jankae/BLDCDriver/Hardware/Driver.pdf

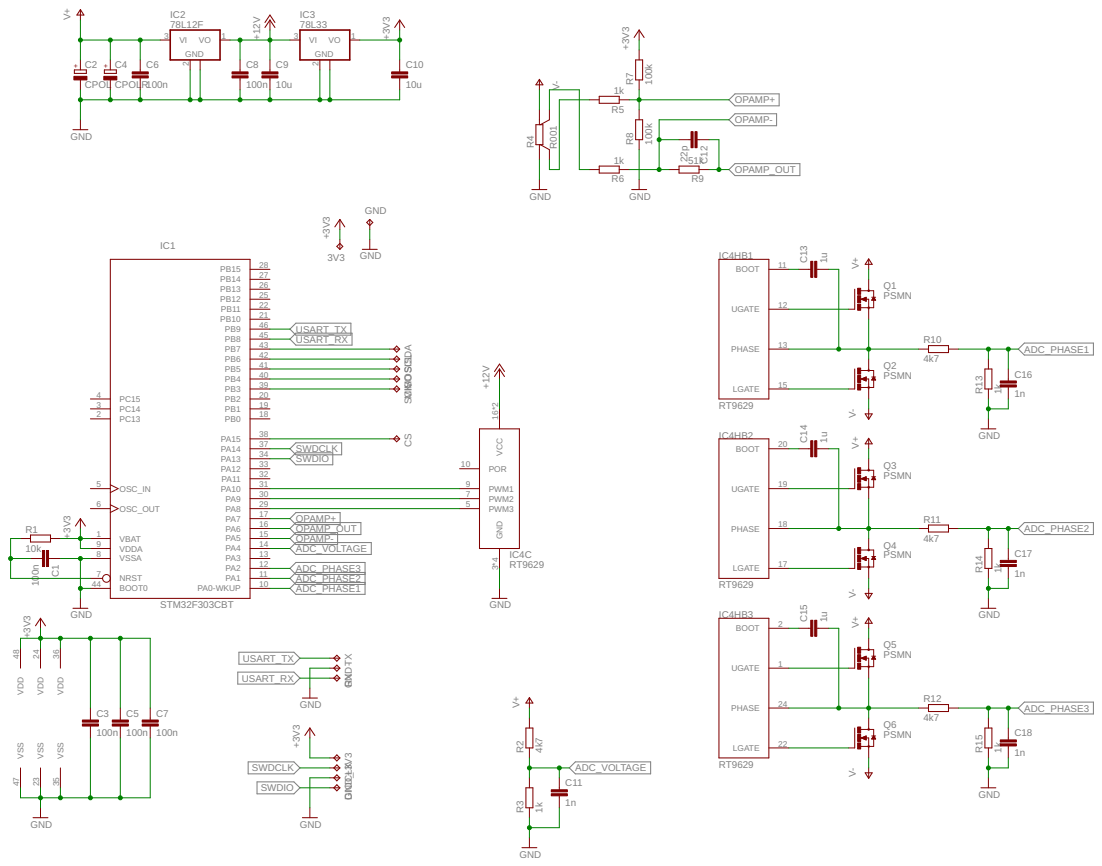
[picture p1: page 1]
