jankae/BLDCDriver/Hardware/Driver.brd

## EAGLE design Hardware/Driver.brd (2018-08-25)

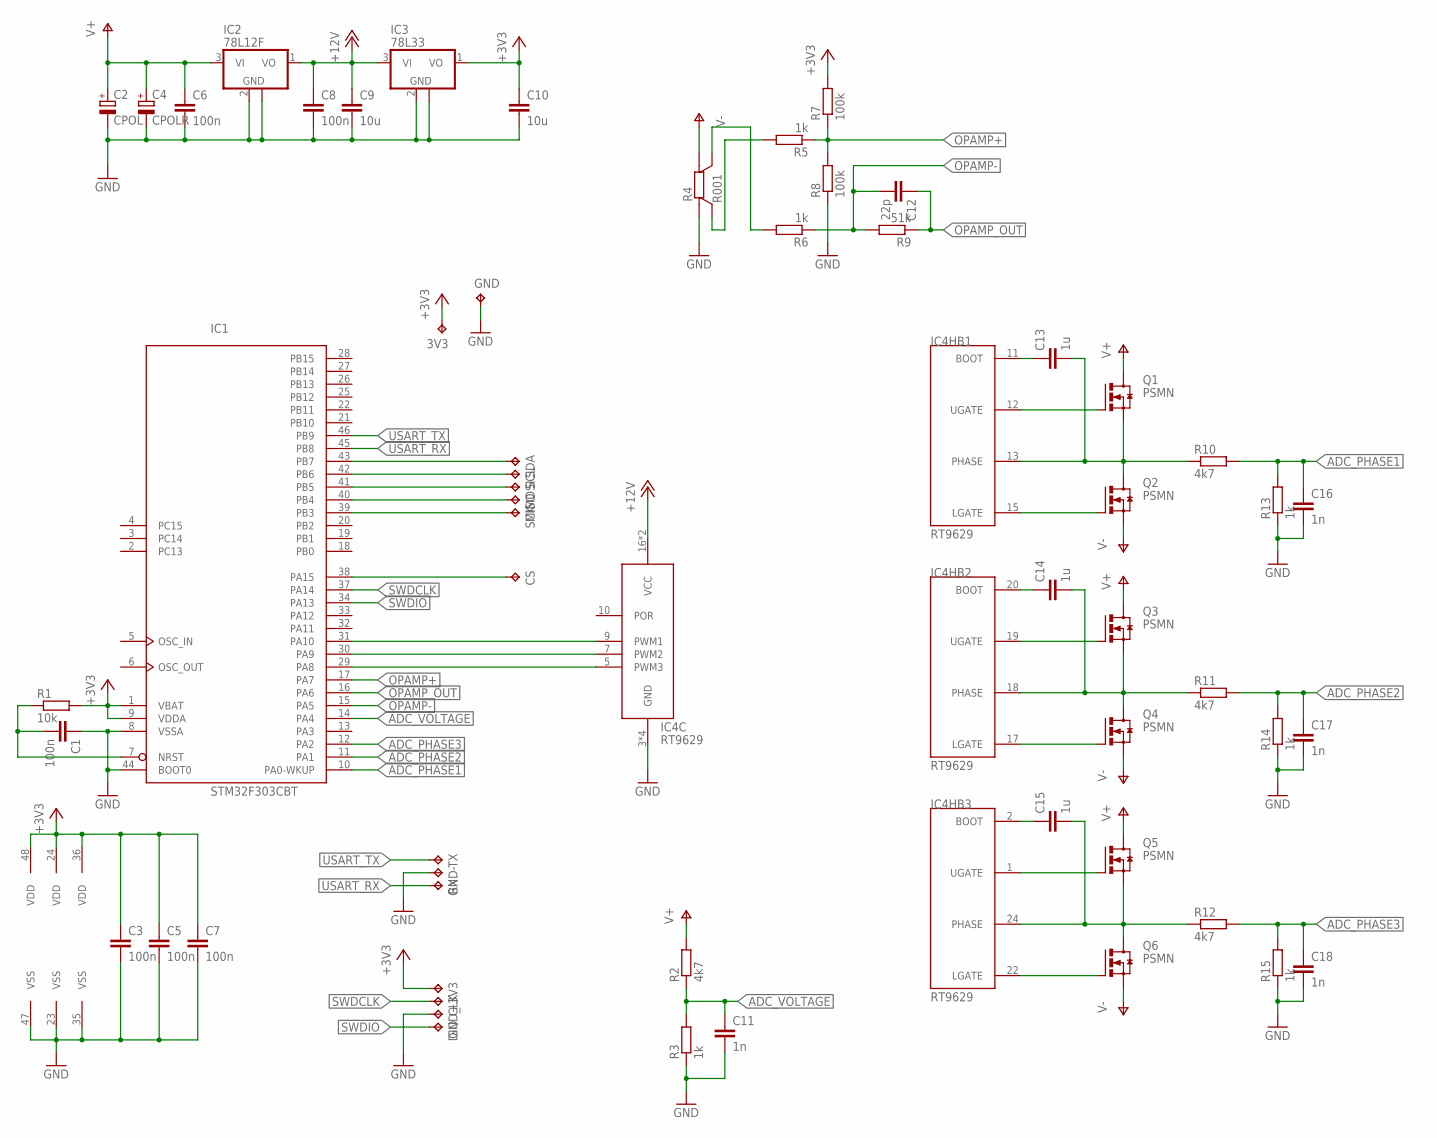
[picture p2: schematic Driver.sch]

Parts:
3V3: TPTP10SQ; TP10SQ
+3V3: TPTP15R; TP15R
C1, C3, C5, C6, C7, C8: 100n; C0603K
C2: CPOL; SIDEWAYS-5.08
C4: CPOLR; SIDEWAYS-5.08R
C9, C10: 10u; C1206K
C11, C16, C17, C18: 1n; C0603K
C12: 22p; C0603K
C13, C14, C15: 1u; C0603K
CLK: TPTP15R; TP15R
CS: TPTP10SQ; TP10SQ
DIO: TPTP15R; TP15R
GND: TPTP10SQ; TP10SQ
GND-: TPTP15SQ; TP15SQ
GND_: TPTP15SQ; TP15SQ
IC1: STM32F303CBT; LQFP48
IC2: 78L12F; SOT89
IC3: 78L33; SOT89
IC4: RT9629; WQFN24
MISO: TPTP10SQ; TP10SQ
MOSI: TPTP10SQ; TP10SQ
Q1, Q2, Q3, Q4, Q5, Q6: PSMN; SOT669
R1: 10k; R0603
R2, R10, R11, R12: 4k7; R0603
R3, R5, R6, R13, R14, R15: 1k; R0603
R4: R001; WSK1216
R7, R8: 100k; R0603
R9: 51k; R0603
RX: TPTP15R; TP15R
SCK: TPTP10SQ; TP10SQ
SCL: TPTP10SQ; TP10SQ
SDA: TPTP10SQ; TP10SQ
TX: TPTP15R; TP15R

Connections:
+3V3: 3V3.TP, +3V3.TP, C3.1, C5.1, C7.1, C10.1, IC1.1 (VBAT), IC1.9 (VDDA), IC1.24 (VDD), IC1.36 (VDD), IC1.48 (VDD), IC3.1 (VO), R1.2, R7.2
+12V: C8.1, C9.1, IC2.1 (VO), IC3.3 (VI), IC4.16 (VCC), IC4.21 (VCC)
ADC_PHASE1: C16.1, IC1.10 (PA0-WKUP), R10.2, R13.2
ADC_PHASE2: C17.1, IC1.11 (PA1), R11.2, R14.2
ADC_PHASE3: C18.1, IC1.12 (PA2), R12.2, R15.2
ADC_VOLTAGE: C11.1, IC1.14 (PA4), R2.1, R3.2
GND: C1.1, C2.-, C3.2, C4.-, C5.2, C6.2, C7.2, C8.2, C9.2, C10.2, C11.2, C16.2, C17.2, C18.2, GND.TP, GND-.TP, GND_.TP, IC1.8 (VSSA), IC1.23 (VSS), IC1.35 (VSS), IC1.44 (BOOT0), IC1.47 (VSS), IC2.2 (GND), IC2.2@1 (GND), IC3.2 (GND), IC3.2@1 (GND), IC4.3 (GND), IC4.14 (GND), IC4.23 (GND), IC4.E (GND), R3.1, R4.B, R8.1, R13.1, R14.1, R15.1
I2C_SCL: IC1.42 (PB6), SCL.TP
I2C_SDA: IC1.43 (PB7), SDA.TP
unnamed: IC4.12 (UGATE), Q1.4 (G)
unnamed: IC4.15 (LGATE), Q2.4 (G)
unnamed: C13.1, IC4.11 (BOOT)
unnamed: C14.1, IC4.20 (BOOT)
unnamed: IC4.19 (UGATE), Q3.4 (G)
unnamed: IC4.17 (LGATE), Q4.4 (G)
unnamed: C15.1, IC4.2 (BOOT)
unnamed: IC4.1 (UGATE), Q5.4 (G)
unnamed: IC4.22 (LGATE), Q6.4 (G)
unnamed: C1.2, IC1.7 (NRST), R1.1
unnamed: R4.SA, R6.2
unnamed: R4.SB, R5.2
OPAMP+: IC1.17 (PA7), R5.1, R7.1, R8.2
OPAMP-: C12.2, IC1.15 (PA5), R6.1, R9.2
OPAMP_OUT: C12.1, IC1.16 (PA6), R9.1
PHASE1: C13.2, IC4.13 (PHASE), Q1.1 (S), Q1.2 (S), Q1.3 (S), Q2.MB (D), R10.1
PHASE2: C14.2, IC4.18 (PHASE), Q3.1 (S), Q3.2 (S), Q3.3 (S), Q4.MB (D), R11.1
PHASE3: C15.2, IC4.24 (PHASE), Q5.1 (S), Q5.2 (S), Q5.3 (S), Q6.MB (D), R12.1
PWM1: IC1.31 (PA10), IC4.9 (PWM1)
PWM2: IC1.30 (PA9), IC4.7 (PWM2)
PWM3: IC1.29 (PA8), IC4.5 (PWM3)
SPI_MISO: IC1.40 (PB4), MISO.TP
SPI_MOSI: IC1.41 (PB5), MOSI.TP
SPI_NSS: CS.TP, IC1.38 (PA15)
SPI_SCK: IC1.39 (PB3), SCK.TP
SWDCLK: CLK.TP, IC1.37 (PA14)
SWDIO: DIO.TP, IC1.34 (PA13)
USART_RX: IC1.45 (PB8), RX.TP
USART_TX: IC1.46 (PB9), TX.TP
V+: C2.+, C4.+, C6.1, IC2.3 (VI), Q1.MB (D), Q3.MB (D), Q5.MB (D), R2.2
V-: Q2.1 (S), Q2.2 (S), Q2.3 (S), Q4.1 (S), Q4.2 (S), Q4.3 (S), Q6.1 (S), Q6.2 (S), Q6.3 (S), R4.A

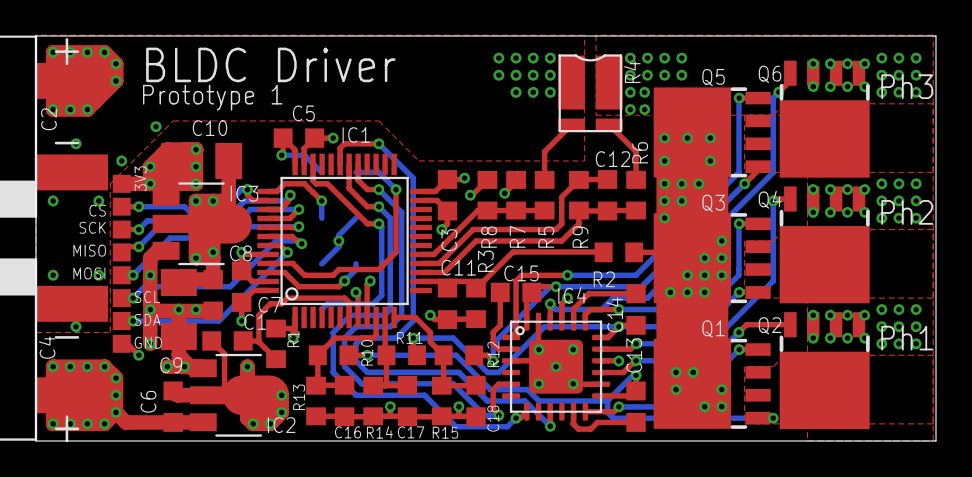
[picture p3: board Driver.brd from above]

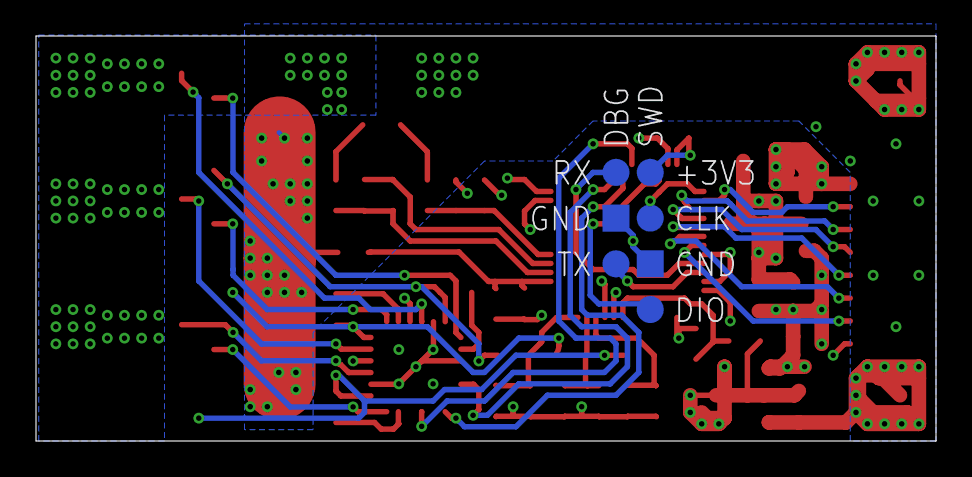
[picture p4: board Driver.brd from below]

Board: 4 copper layers, 50.0 x 22.5 mm, 58 parts (7 on the bottom side), 40 nets.
