jankae/BLDCDriver/Software/BLDC/BLDC.ioc

Mcu.UserName=STM32F303C8Tx
PA0.Signal=ADC1_IN1
PA1.Signal=ADC1_IN2
PA10.GPIO_Label=PHASE_A
PA10.Signal=S_TIM1_CH3
PA13.Signal=SYS_JTMS-SWDIO
PA14.Signal=SYS_JTCK-SWCLK
PA15.Signal=SPI1_NSS
PA2.Signal=ADC1_IN3
PA4.Signal=ADC2_IN1
PA5.Signal=OPAMP2_VINM
PA6.Signal=OPAMP2_VOUT
PA7.Signal=OPAMP2_VINP
PA8.GPIO_Label=PHASE_C
PA8.Signal=S_TIM1_CH1
PA9.GPIO_Label=PHASE_B
PA9.Signal=S_TIM1_CH2
PB11.Signal=USART3_RX
PB3.Signal=SPI1_SCK
PB4.Signal=SPI1_MISO
PB5.Signal=SPI1_MOSI
PB6.Signal=I2C1_SCL
PB7.Signal=I2C1_SDA
PB8.GPIO_Label=TRIGGER
PB8.Signal=GPIO_Output
PB9.Signal=USART3_TX
