jankae/BLDCDriver/Software/BLDC/Inc/main.h

#define PHASE_C_Pin GPIO_PIN_8
#define PHASE_C_GPIO_Port GPIOA
#define PHASE_B_Pin GPIO_PIN_9
#define PHASE_B_GPIO_Port GPIOA
#define PHASE_A_Pin GPIO_PIN_10
#define PHASE_A_GPIO_Port GPIOA
#define TRIGGER_Pin GPIO_PIN_8
#define TRIGGER_GPIO_Port GPIOB
