jankae/BLDCDriver/Software/BLDC/Core/Sysinfo.hpp

#pragma once

#include "BLDCHAL.hpp"

//namespace HAL {
//namespace BLDC {
//class HALDriver;
//}
//}

namespace Core {
// Forward declare used classes
class Communication;
class Propeller;

using Sysinfo = struct sysinfo {
	Propeller *prop;
	Communication *communication;
	HAL::BLDC::HALDriver *driver;
};

}
