jankae/BLDCDriver/Software/BLDC/HAL/PowerADC.hpp

#pragma once

#include <cstdint>

namespace HAL {
namespace BLDC {
namespace PowerADC {

using Measurement = struct meas {
	uint32_t voltage; // in mV
	int32_t current; // in mA
	uint32_t energy; // in uJ
};

void Init();
void Pause();
void Resume();

void SetMaximumVoltageThreshold(uint16_t mV);
bool VoltageWithinLimits();

void DMAComplete();
void DMAHalfComplete();

void PrintBuffer();

int32_t CurrentFromRaw(uint16_t adc);
uint32_t VoltageFromRaw(uint16_t adc);

Measurement GetSmoothed();
Measurement GetInstant();


}
}
}
