jankae/BLDCDriver/Software/BLDC/Src/Operators.cpp

#include "FreeRTOS.h"
#include <cstdio>

void * operator new(size_t size)
{
	return pvPortMalloc(size);
}

void * operator new[](size_t size)
{
	return pvPortMalloc(size);
}

void operator delete(void* ptr)
{
    vPortFree(ptr);
}

void operator delete(void* ptr, unsigned int size)
{
    vPortFree(ptr);
}

void operator delete[](void* ptr)
{
    vPortFree(ptr);
}

void operator delete[](void* ptr, unsigned int size)
{
    vPortFree(ptr);
}
