jankae/BLDCDriver/Software/BLDC/HAL/Tests.cpp

#include "Tests.hpp"

#include "FreeRTOS.h"
#include "task.h"
#include "stm32f3xx_hal.h"
#include "lowlevel.hpp"
#include "Logging.hpp"
#include "Driver.hpp"
#include "InductanceSensing.hpp"
#include "PowerADC.hpp"
#include "Persistance.hpp"
#include "Sysinfo.hpp"
#include "Propeller.hpp"

extern Core::Sysinfo sys;
extern HAL::BLDC::Driver *d;

using namespace HAL::BLDC;

void Test::DifferentPWMs(void) {
	Log::Uart(Log::Lvl::Inf, "Test, setting different PWMs");
	LowLevel::SetPWM(100);
	LowLevel::SetPhase(LowLevel::Phase::A, LowLevel::State::High);
	LowLevel::SetPhase(LowLevel::Phase::B, LowLevel::State::Low);
	LowLevel::SetPhase(LowLevel::Phase::C, LowLevel::State::Idle);
}

void Test::MotorFunctions(void) {
	while (1) {
		sys.driver->InitiateStart();
		vTaskDelay(3000);
		constexpr uint16_t maxPWM = 200;
		for (uint16_t pwm = 100; pwm <= maxPWM; pwm++) {
			sys.driver->SetPWM(pwm);
			vTaskDelay(10);
		}
		for (uint16_t pwm = maxPWM; pwm > 100; pwm--) {
			sys.driver->SetPWM(pwm);
			vTaskDelay(10);
		}
		sys.driver->Stop();
		vTaskDelay(2000);
	}
}

static void SetStep(uint8_t step) {
	switch (step) {
	case 0:
		LowLevel::SetPhase(LowLevel::Phase::A, LowLevel::State::High);
		LowLevel::SetPhase(LowLevel::Phase::B, LowLevel::State::Idle);
		LowLevel::SetPhase(LowLevel::Phase::C, LowLevel::State::Low);
		break;
	case 1:
		LowLevel::SetPhase(LowLevel::Phase::A, LowLevel::State::High);
		LowLevel::SetPhase(LowLevel::Phase::B, LowLevel::State::Low);
		LowLevel::SetPhase(LowLevel::Phase::C, LowLevel::State::Idle);
		break;
	case 2:
		LowLevel::SetPhase(LowLevel::Phase::A, LowLevel::State::Idle);
		LowLevel::SetPhase(LowLevel::Phase::B, LowLevel::State::Low);
		LowLevel::SetPhase(LowLevel::Phase::C, LowLevel::State::High);
		break;
	case 3:
		LowLevel::SetPhase(LowLevel::Phase::A, LowLevel::State::Low);
		LowLevel::SetPhase(LowLevel::Phase::B, LowLevel::State::Idle);
		LowLevel::SetPhase(LowLevel::Phase::C, LowLevel::State::High);
		break;
	case 4:
		LowLevel::SetPhase(LowLevel::Phase::A, LowLevel::State::Low);
		LowLevel::SetPhase(LowLevel::Phase::B, LowLevel::State::High);
		LowLevel::SetPhase(LowLevel::Phase::C, LowLevel::State::Idle);
		break;
	case 5:
		LowLevel::SetPhase(LowLevel::Phase::A, LowLevel::State::Idle);
		LowLevel::SetPhase(LowLevel::Phase::B, LowLevel::State::High);
		LowLevel::SetPhase(LowLevel::Phase::C, LowLevel::State::Low);
		break;
	}
}

void Test::InductanceSense() {
	delete sys.driver;
	while (1) {
		int8_t pos = InductanceSensing::RotorPosition();
		Log::Uart(Log::Lvl::Inf, "Pos: %d", pos);
		pos = (pos + 1) % 6;
		LowLevel::SetPWM(100);
		SetStep(pos);
		vTaskDelay(1000);
		LowLevel::SetPWM(0);
		LowLevel::SetPhase(LowLevel::Phase::A, LowLevel::State::Idle);
		LowLevel::SetPhase(LowLevel::Phase::B, LowLevel::State::Idle);
		LowLevel::SetPhase(LowLevel::Phase::C, LowLevel::State::Idle);
		vTaskDelay(1000);
	}
}

void Test::MotorManualStart(void) {
	while (1) {
		Log::Uart(Log::Lvl::Inf, "Waiting for external start");
		while(!d->GotValidPosition()) {
			vTaskDelay(10);
		}
		d->InitiateStart();
		vTaskDelay(2000);
		d->FreeRunning();
		while(d->GotValidPosition()) {
			vTaskDelay(10);
		}
		vTaskDelay(500);
	}
}

void Test::PowerADC() {
	d->InitiateStart();
	while(1) {
		auto m = HAL::BLDC::PowerADC::GetSmoothed();
		Log::Uart(Log::Lvl::Inf, "U: %lu, I: %ld", m.voltage, m.current);
		vTaskDelay(5);
	}
}

void Test::ManualCommutation() {
	uint8_t step = 0;

	for (uint8_t i = 0; i < 12; i++) {
		step = (step + 1) % 6;

		LowLevel::SetPWM(100);
		SetStep(step);
		vTaskDelay(2000);
	}
	LowLevel::SetPWM(0);
	LowLevel::SetPhase(LowLevel::Phase::A, LowLevel::State::Idle);
	LowLevel::SetPhase(LowLevel::Phase::B, LowLevel::State::Idle);
	LowLevel::SetPhase(LowLevel::Phase::C, LowLevel::State::Idle);
}

void Test::DummyWindspeedEstimation() {
	float power = 30.0f;
	uint16_t rpm = 4000;
	while(1) {
		sys.prop->Update((float) rpm, power);
	}
}

void Test::MotorCharacterisation() {
	Log::Uart(Log::Lvl::Inf, "Starting motor characterisation");
	vTaskDelay(100);
	uint32_t inductance = InductanceSensing::WindingInductance();
	Log::Uart(Log::Lvl::Inf, "Winding inductance: %lunH", inductance);
	uint32_t resistance = d->WindingResistance();
	Log::Uart(Log::Lvl::Inf, "Winding resistance: %lumR", resistance);
	vTaskDelay(10);
	d->Stop();
	vTaskDelay(100);
	d->FreeRunning();
	vTaskDelay(100);
	d->InitiateStart();
	vTaskDelay(500);
	d->SetPWM(200);
	vTaskDelay(1000);
	// dummy measurements to reset smoothed values
	PowerADC::GetSmoothed();
	d->GetRPMSmoothed();
	vTaskDelay(1000);
	uint16_t highRPM = d->GetRPMSmoothed();
	auto m = PowerADC::GetSmoothed();

	uint32_t Vmotor = m.voltage * 200 / 1000;
	int32_t Imotor = m.current * 1000 / 200;
	uint32_t backEMF = Vmotor - Imotor * resistance / 1000;
	uint32_t Kv = (uint32_t) highRPM * 1000 / backEMF;
	Log::Uart(Log::Lvl::Inf, "Kv: %lu", Kv);

	d->SetPWM(100);
	d->GetRPMSmoothed();
	vTaskDelay(1000);
	uint16_t lowRPM = d->GetRPMSmoothed();
	PowerADC::GetSmoothed();
	vTaskDelay(10);
	auto slow = PowerADC::GetSmoothed();
	d->SetPWM(200);
	uint16_t PWMThreshold = lowRPM + (highRPM - lowRPM) * 0.9;
	uint16_t nowRPM = 0;
	auto t1 = HAL_GetTick();
	while (nowRPM < PWMThreshold) {
		nowRPM = d->GetRPMInstant();
	}
	auto t2 = HAL_GetTick();
	auto acc = PowerADC::GetSmoothed();
	vTaskDelay(100);
	PowerADC::GetSmoothed();
	vTaskDelay(10);
	auto fast = PowerADC::GetSmoothed();
	vTaskDelay(500);
	d->FreeRunning();

	// extra energy needed for speedup
	uint32_t energySlow_ms = slow.energy / 10;
	uint32_t energyFast_ms = fast.energy / 10;
	uint32_t energyExcess = acc.energy
			- (energySlow_ms + energyFast_ms) / 2 * (t2 - t1);
	float low_rad = (float) lowRPM * 2 * 3.141f / 60;
	float high_rad = (float) highRPM * 2 * 3.141f / 60;
	float E = (float) energyExcess / 1000000UL;
	float I = 2 * E / (high_rad * high_rad - low_rad * low_rad);


	Log::Uart(Log::Lvl::Inf, "RPM: %d/%d/%d, took %lums", lowRPM, highRPM,
			nowRPM, t2 - t1);
	Log::Uart(Log::Lvl::Inf, "Energy: %lu/%lu/%lu", slow.energy, acc.energy, fast.energy);
	Log::Uart(Log::Lvl::Inf, "Inertia: %f, E: %f", I, E);
}

void Test::WindEstimation() {
	Log::Uart(Log::Lvl::Inf, "Starting motor characterisation");
	vTaskDelay(100);
	uint32_t resistance = d->WindingResistance();
	vTaskDelay(500);
	Log::Uart(Log::Lvl::Inf, "Winding resistance: %lumR", resistance);

	constexpr uint16_t PWMvalue = 600;


	d->InitiateStart();
	vTaskDelay(500);
	d->SetPWM(PWMvalue);
	d->GetRPMSmoothed();
	PowerADC::GetSmoothed();
	uint32_t cnt = 0;
	Log::Uart(Log::Lvl::Inf, "Prop: Vmotor Imotor Power RPM J Ct Cp V");
	while (1) {
		vTaskDelay(10);
		auto rpm = d->GetRPMSmoothed();
		auto m = PowerADC::GetSmoothed();

		// calculate motor output power
		uint32_t Vmotor = m.voltage * PWMvalue / 1000;
		int32_t Imotor = m.current * 1000 / PWMvalue;
		uint32_t backEMF = Vmotor - Imotor * resistance / 1000;
		float power = (float) backEMF / 1000 * (float) Imotor / 1000;
		constexpr float efficiency = 0.85;
		power *= efficiency;
		sys.prop->Update(rpm, power);
		if (++cnt >= 50) {
			Log::Uart(Log::Lvl::Inf,
					"Prop: %lu %lu %5.2f %d %4.2f %9.6f %9.6f %9.3f", Vmotor,
					Imotor, power, rpm, sys.prop->J, sys.prop->Ct, sys.prop->Cp,
					sys.prop->V);
			cnt = 0;
		}
	}
}
//static uint32_t testdata[4] __attribute__ ((section (".ccmpersist")));
//
//void Test::PersistenceTest() {
//	Persistance::Load();
//	Log::Uart(Log::Lvl::Inf, "Previous data: %x %x %x %x", testdata[0], testdata[1], testdata[2], testdata[3]);
//	testdata[0] = 0xdeadbeef;
//	testdata[1] = 0xdeadbeef;
//	testdata[2] = 0xdeadbeef;
//	testdata[3] = 0xdeadbeef;
//	Log::Uart(Log::Lvl::Inf, "Set data: %x %x %x %x", testdata[0], testdata[1], testdata[2], testdata[3]);
//	Persistance::Store();
//	Persistance::Load();
//	Log::Uart(Log::Lvl::Inf, "Afterwards data: %x %x %x %x", testdata[0], testdata[1], testdata[2], testdata[3]);
//}
