jankae/BLDCDriver/Software/BLDC/HAL/Tests.hpp

#pragma once

namespace Test {

void DifferentPWMs(void);
void MotorFunctions(void);
void MotorManualStart(void);
void InductanceSense();
void PowerADC();

void ManualCommutation();

void DummyWindspeedEstimation();

void MotorCharacterisation();
void WindEstimation();

//void PersistenceTest();

}
