jankae/BLDCDriver/(commit log)

2018-08-16 Hardware prototype 1 + CubeMX files
    [Driver.brd, Driver.sch]
2018-08-16 lowest level phase driver + CubeMX update
2018-08-17 commutation detection + better separation of lowlevel/highlevel driver
2018-08-22 Basic BLDC driver, stubs for supporting HAL functions
2018-08-25 Dimensioning R + C
    [Driver.brd, Driver.sch]
2018-08-25 Switched CubeMX to correct MCU version + basic logging module
    [BLDC.ioc, Logging.cpp, Logging.hpp, Startup.cpp, adc.c, critical.hpp, fifo.hpp]
2018-08-25 Bugfixes: ADC buffer length and PWM start
    [BLDC.ioc, BLDCHAL.hpp, Driver.hpp, Logging.cpp, Logging.hpp, Startup.cpp, Tests.cpp, Tests.hpp]
2018-08-27 Detektor experiments, driver improved, motor starts sometimes and runs smooth
2018-09-23 Improved RAM usage, found some problems with interrupt priorities
    [Driver.cpp, Driver.hpp, InductanceSensing.cpp, Logging.cpp, Logging.hpp, PowerADC.cpp, Startup.cpp, Tests.cpp]
2018-09-24 Implemented driver as state machine (mostly backfires at the moment)
2018-09-28 Sensing BEMF during PWM off, motor starts reliable
2018-10-01 Track DC bus voltage and switch to idling when voltage too high (avoids problems with regenerative braking with sink-capable supply)
    [BLDC.ioc, Driver.cpp, Driver.hpp, InductanceSensing.cpp, Logging.cpp, PowerADC.cpp, PowerADC.hpp, Startup.cpp]
2018-10-01 removed no longer needed code
    [Driver.cpp, Driver.hpp, Startup.cpp, Tests.cpp, Tests.hpp, lowlevel.cpp]
2018-10-01 preparations for persistent motor data and current/voltages measurements
2018-10-02 Partial Core::Propeller implementation + basic UART communication
2018-10-02 Fixed bugs in communication and propeller calculations + some motor characterisation methods
    [Communication.cpp, Communication.hpp, Driver.cpp, Driver.hpp, InductanceSensing.cpp, Operators.cpp, PowerADC.cpp]
2019-01-08 Detect a backfiring motor and start again
2019-01-13 CubeMX regenerate + I2C slave driver code
2019-01-14 Baudrate 500000, I2C slave fixed
    [BLDC.ioc, Startup.cpp, i2c_slave.cpp, i2c_slave.hpp]
2019-02-12 Percentage control via I2C implemented
2019-02-14 Coherent mapping from inductance sensing to driver steps
2019-02-16 Logging using DMA (issues with CubeMX regenerating), motor startup almost reliable
    [BLDC.ioc, Driver.cpp, Driver.hpp, Logging.cpp, Logging.hpp, adc.c]
2019-02-18 Measure and report motor data
2019-12-08 PDF of schematic
2020-01-07 Eclipse update
    [BLDC Debug.cfg]
